SmallRoomLabs/PerspiC1/README.md

# PerspiC1 - Schematics
I wanted to see the schematics for the [PerspiC1](https://gnosia.anu.edu.au/wiki/Perspicuous_Computer_1) computer but there wasn't any PDF or image files for them on the site. So
I installed [gschem](http://wiki.geda-project.org/geda:gaf) from the [gEDA](http://www.geda-project.org/) project to be able to open the files.

Since I'm an Eagle user I won't keep the gEDA package on my laptop I made PNG screenshots of all the schematic files to have them available for future reference. They might also come in handy for anyone else that wants to see the schematics without going through the hassle of installing gEDA.

The schematics and pcbs files are copied from  
[svn.anu.edu.au/staff/bob/public/gschem-sym](http://svn.anu.edu.au/staff/bob/public/gschem-sym/)  
[svn.anu.edu.au/staff/bob/public/PerspiC1](http://svn.anu.edu.au/staff/bob/public/PerspiC1/)  

I hope that the designer of PerspiC1, Robert Edwards, don't mind me making the images publically available here.

Update April 2021 - The schematics repo seems offline, so it was a good thing that I uploaded them five years ago. I now also uploaded the wiki pages ( https://gnosia.anu.edu.au/wiki/PerspiC_1_BF_CPU ) since they might go away some day as well. 

---
### 9_bit_oc_buffer.sch
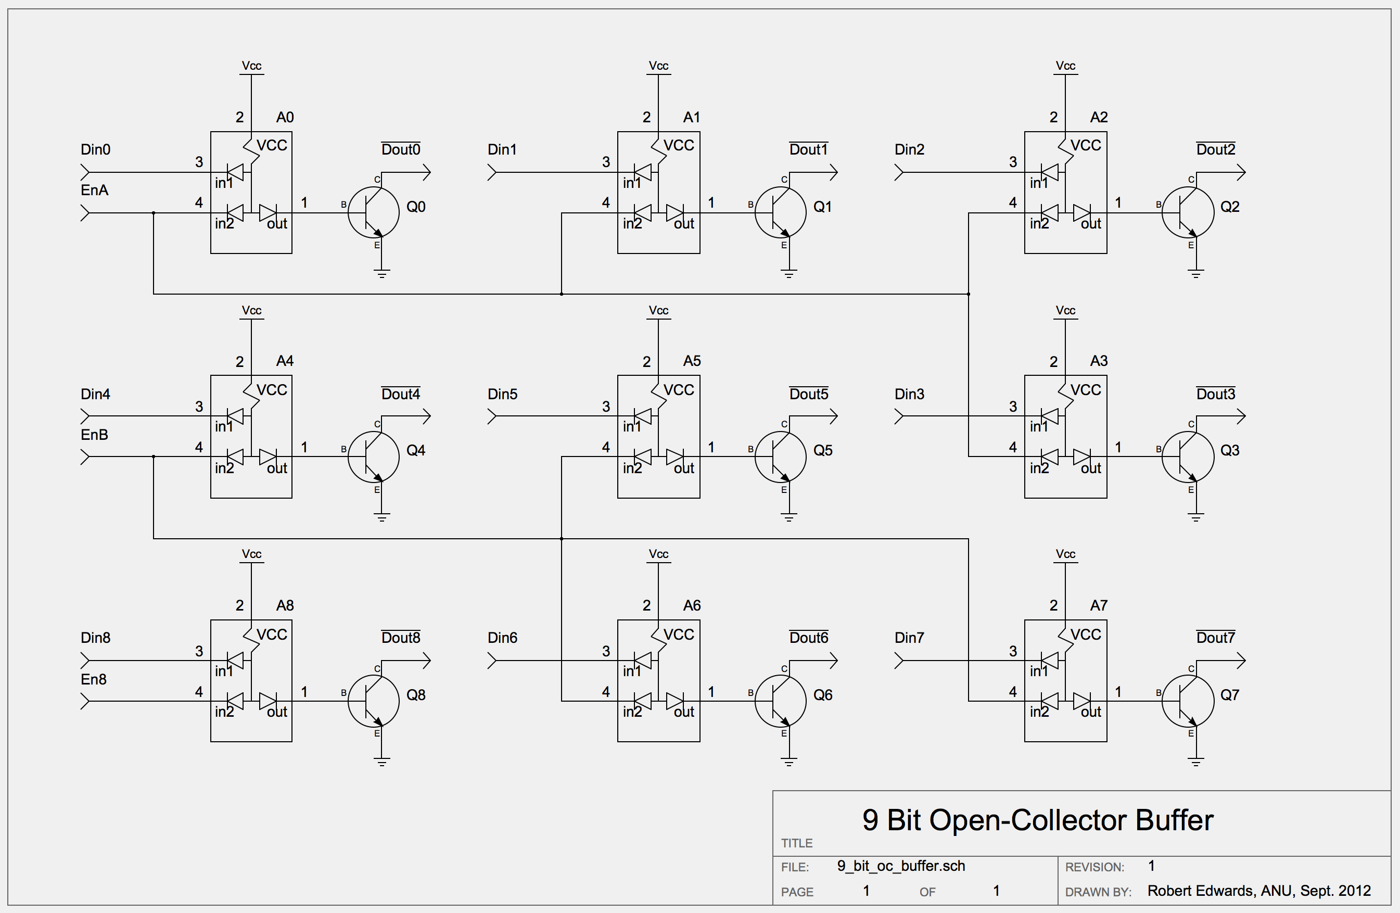
[picture p1: Images/9_bit_oc_buffer.png]


---
### DL_1_and.sch
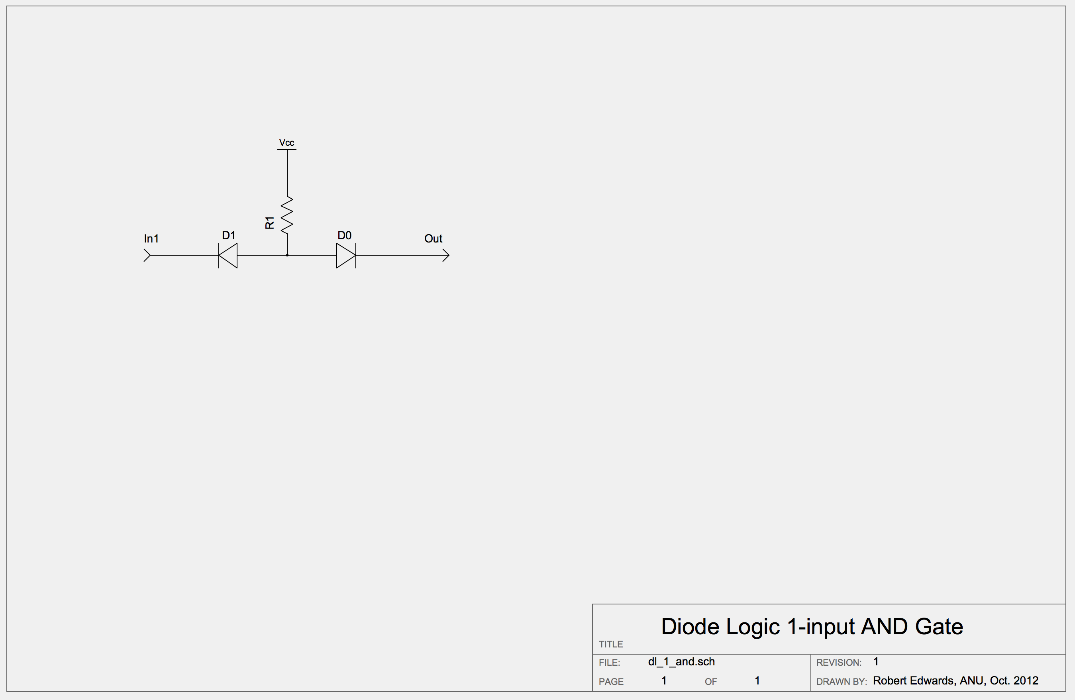
[picture p2: Images/DL_1_and.png]


---
### DL_2_and.sch
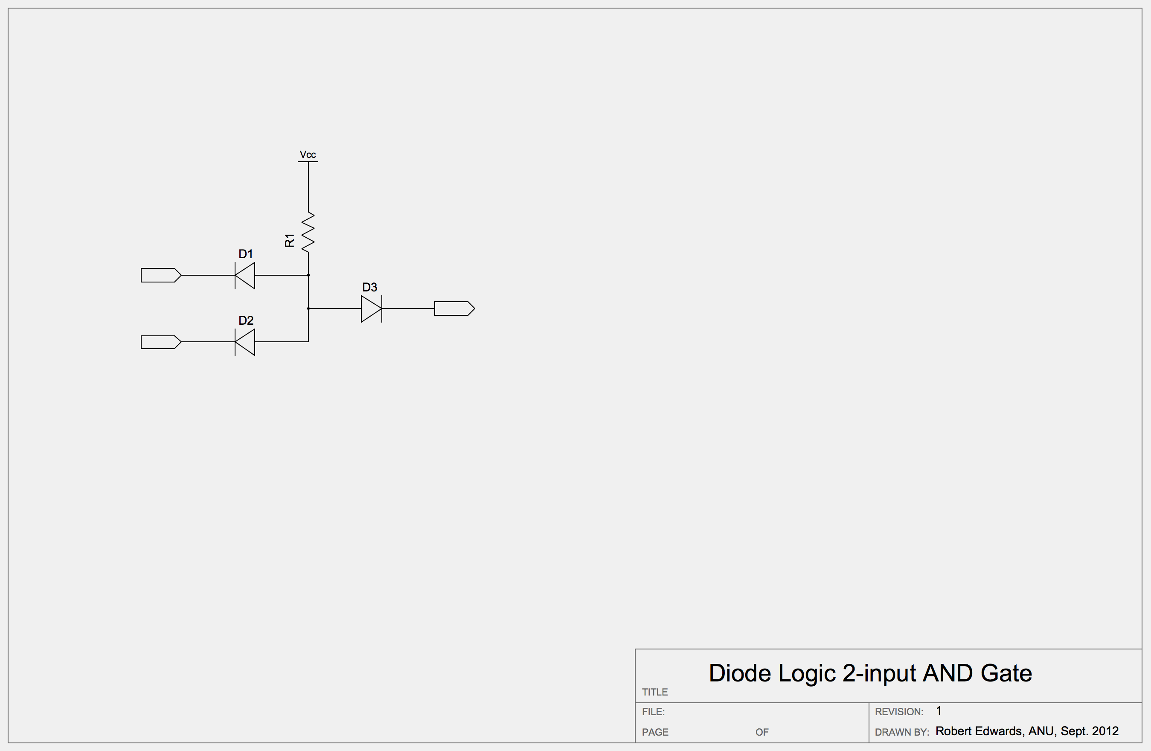
[picture p3: Images/DL_2_and.png]


---
### DL_3_and.sch
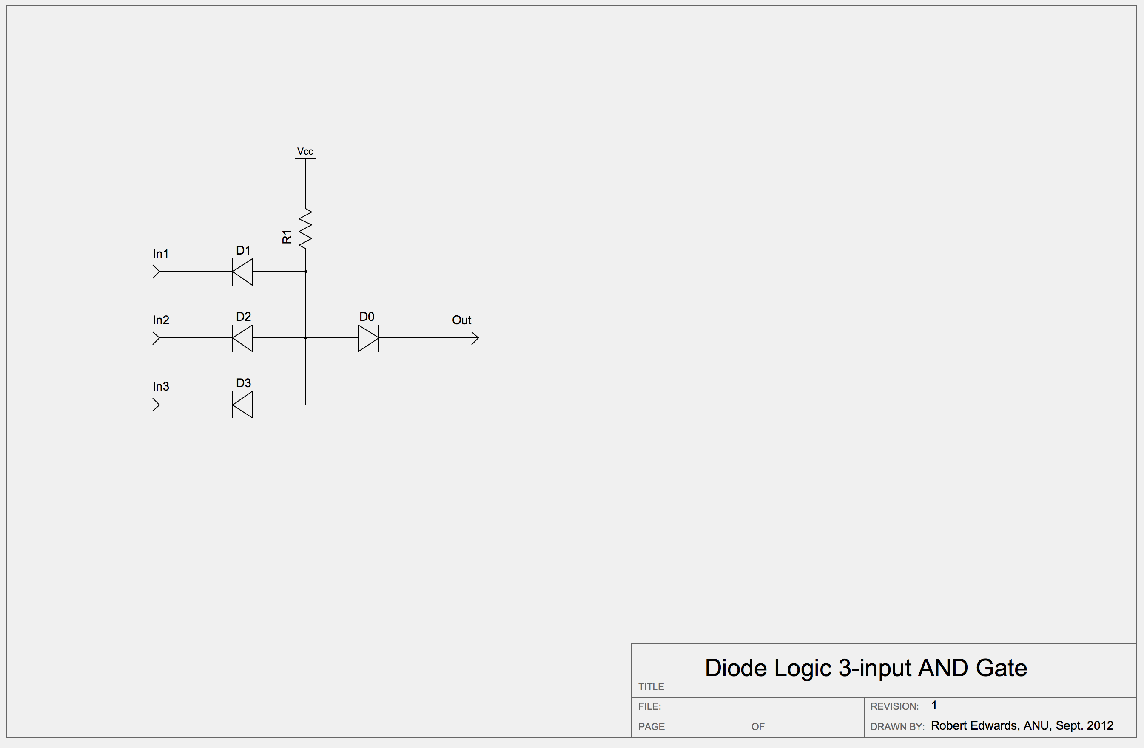
[picture p4: Images/DL_3_and.png]


---
### DL_4_and.sch
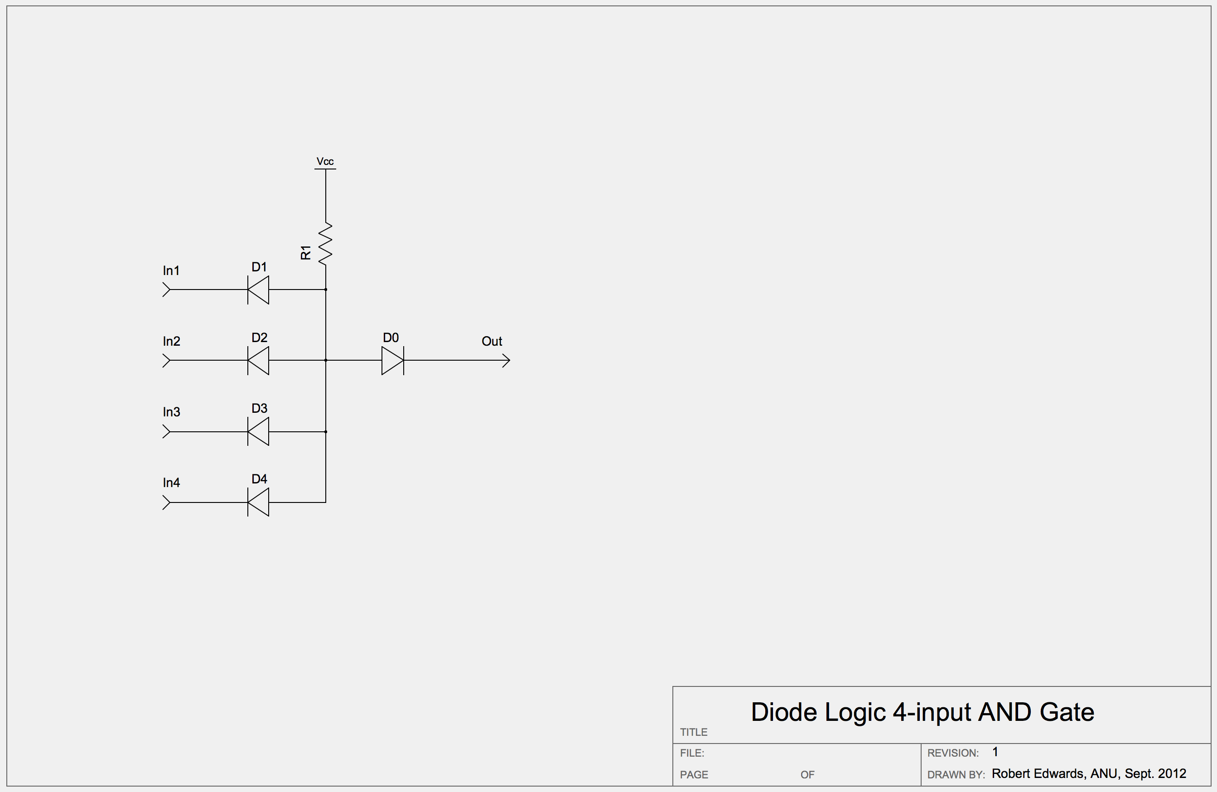
[picture p5: Images/DL_4_and.png]


---
### DTL_3_and.sch
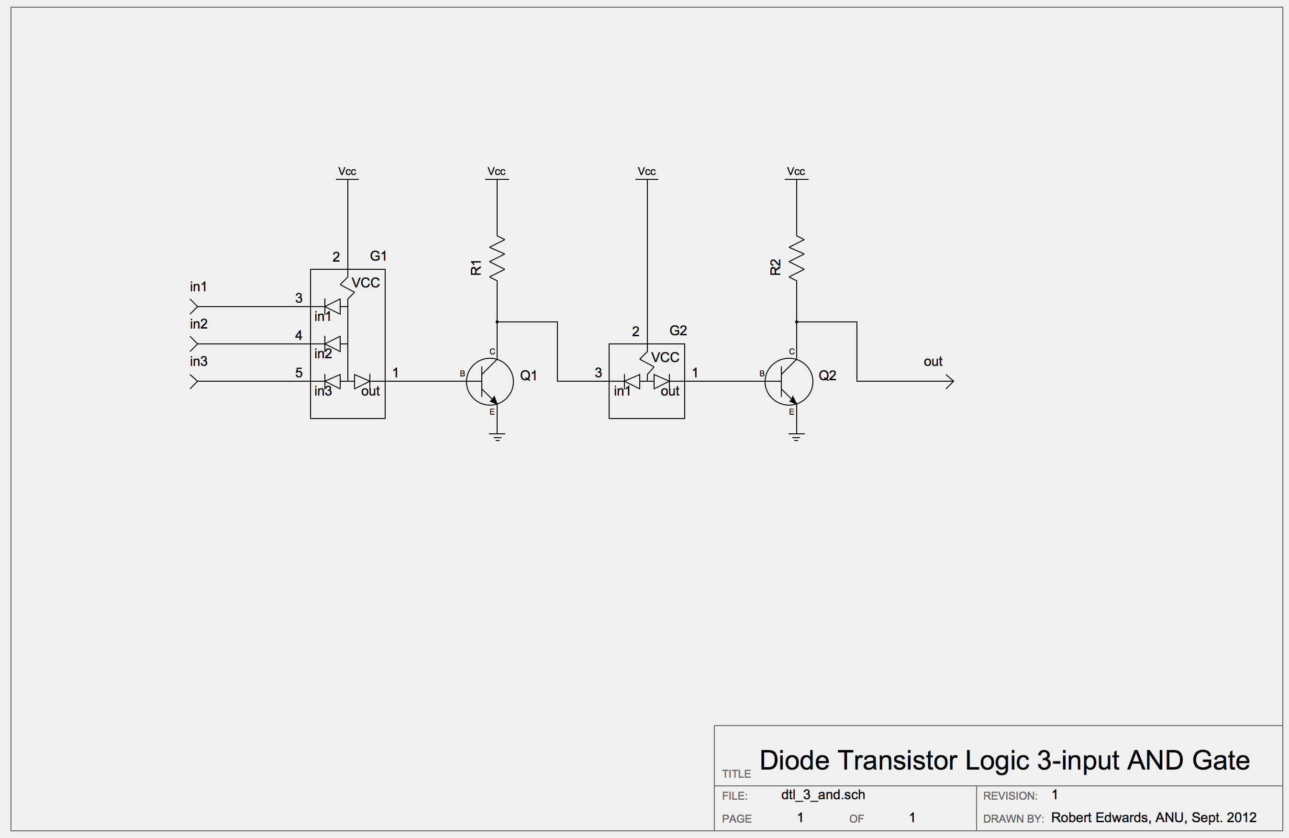
[picture p6: Images/DTL_3_and.png]


---
### DTL_4_and.sch
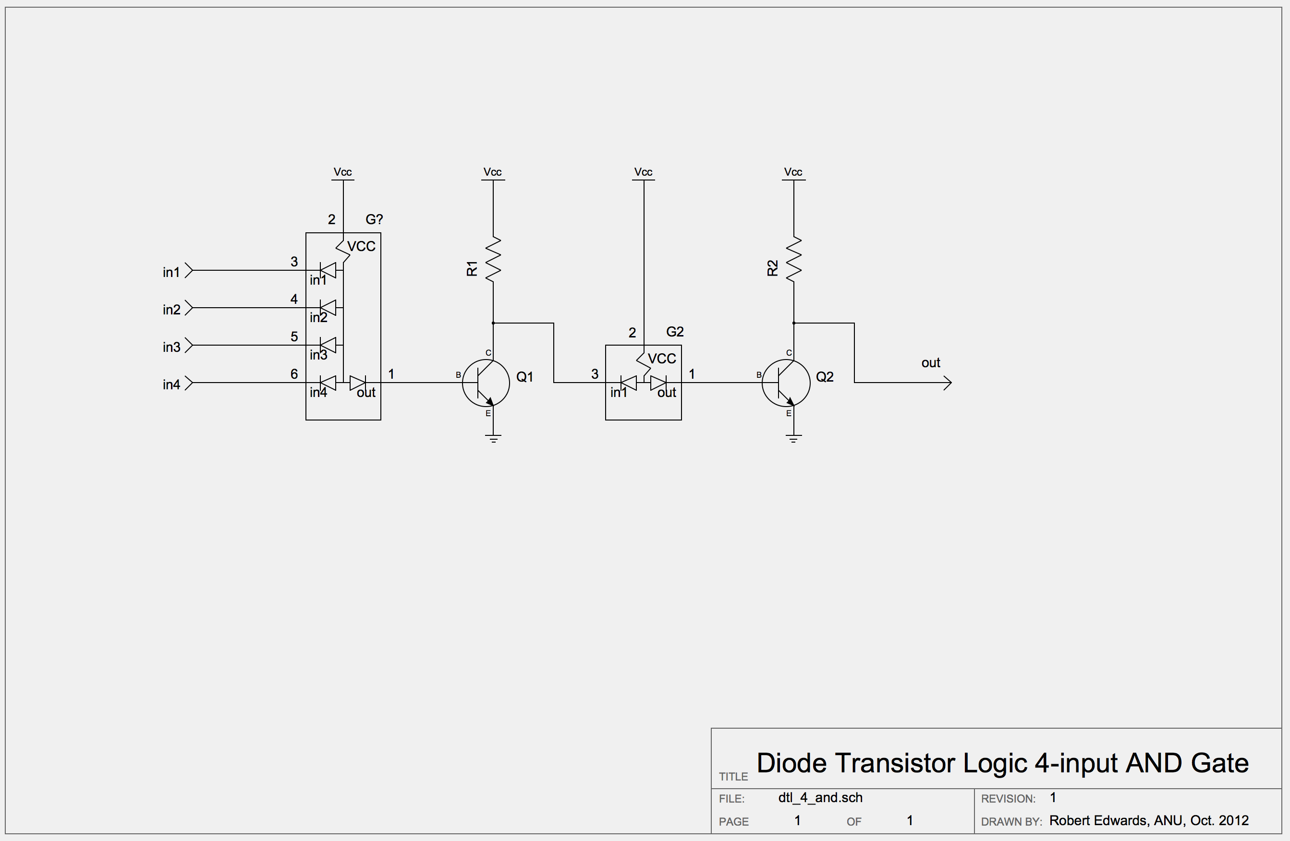
[picture p7: Images/DTL_4_and.png]


---
### DTL_4_and_nand.sch
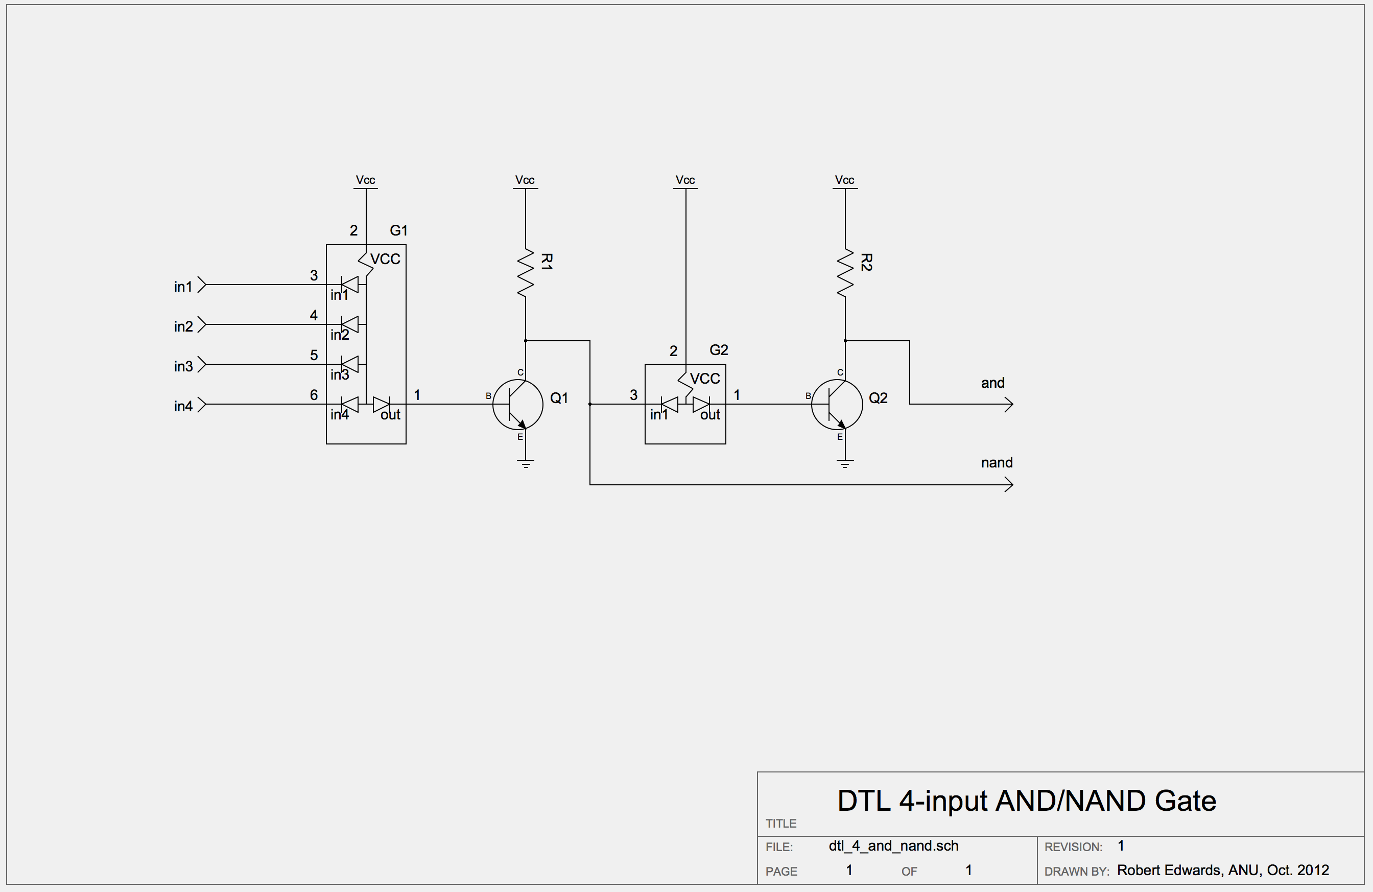
[picture p8: Images/DTL_4_and_nand.png]


---
### DTL_d_latch.sch
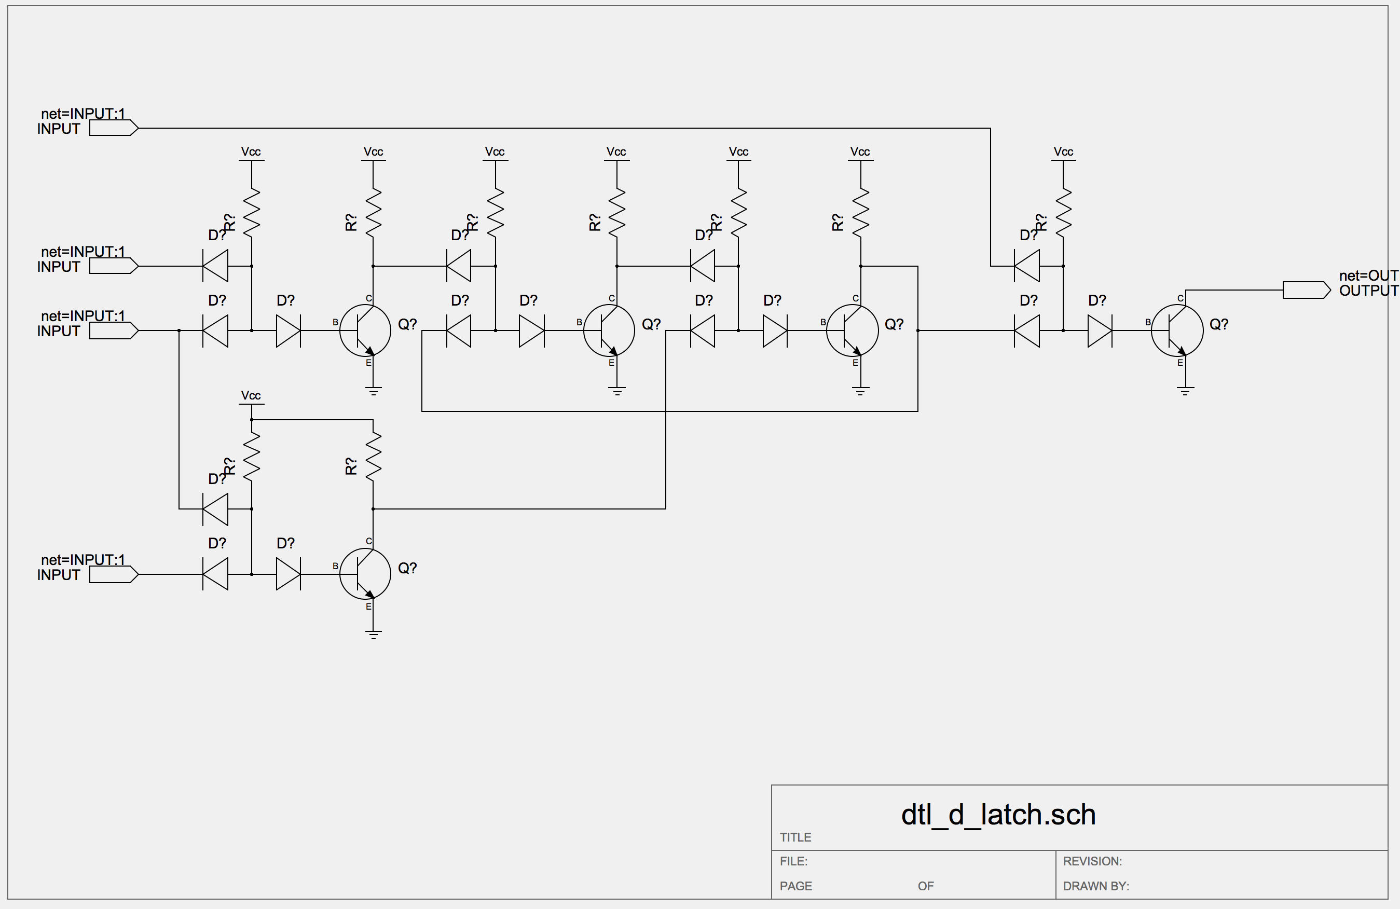
[picture p9: Images/DTL_d_latch.png]


---
### DTL_inv-1.sch
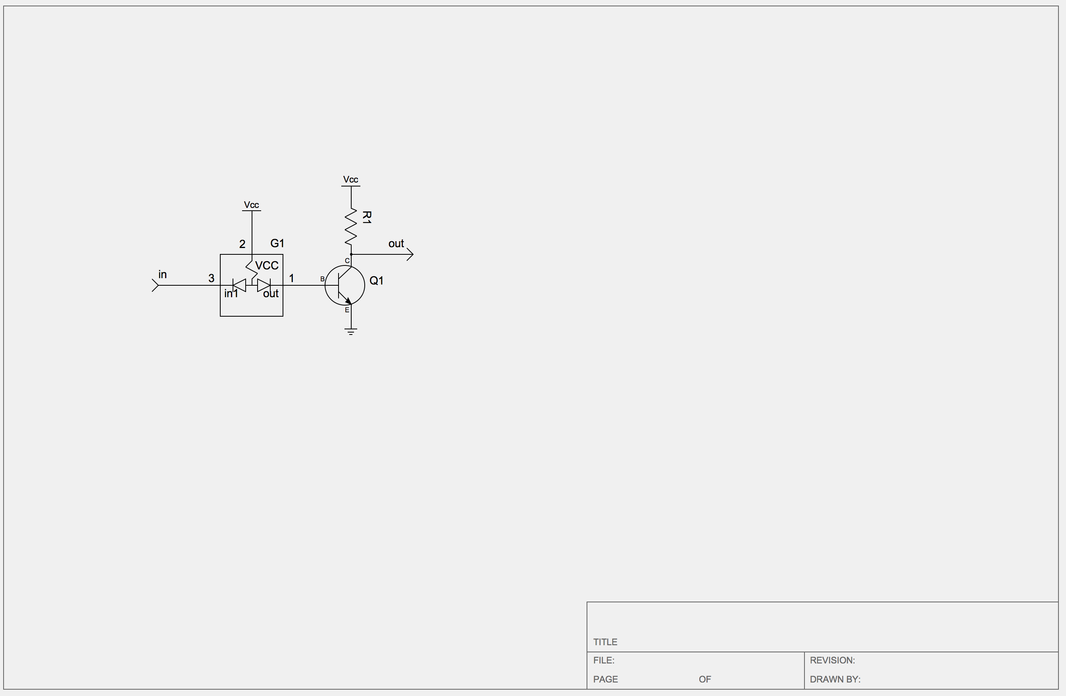
[picture p10: Images/DTL_inv-1.png]


---
### DTL_inv.sch
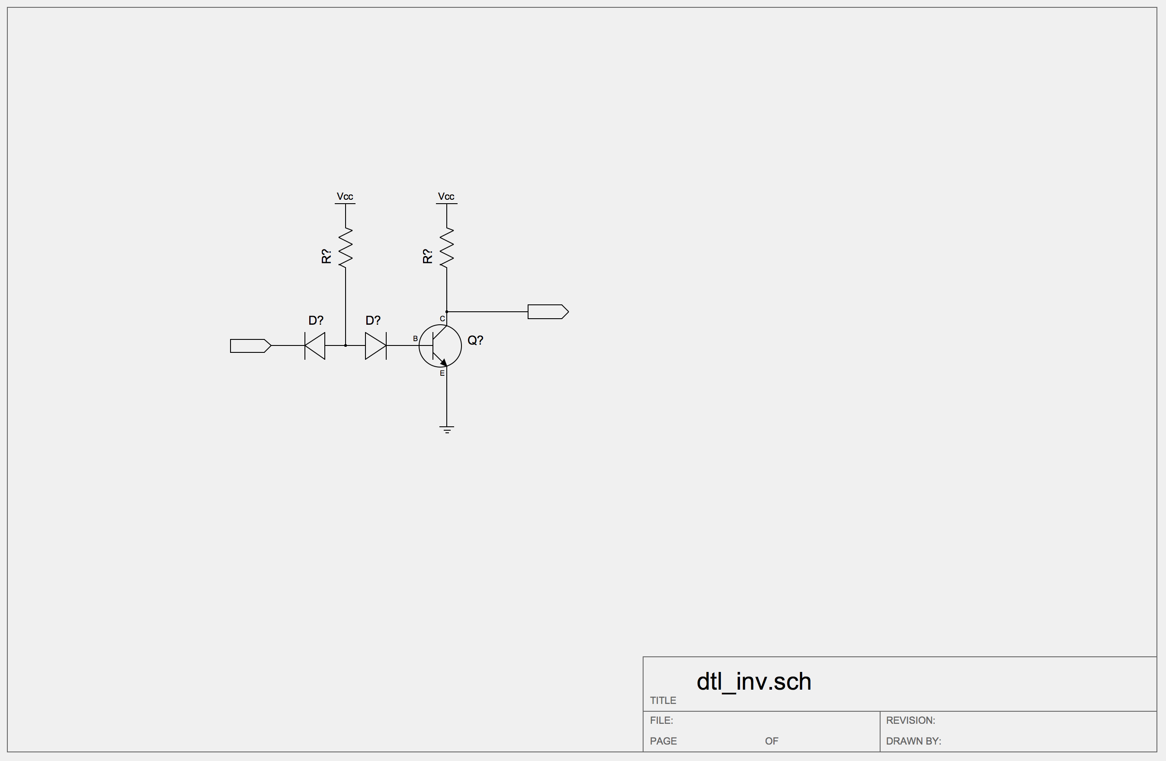
[picture p11: Images/DTL_inv.png]


---
### DTL_ph_latch.sch
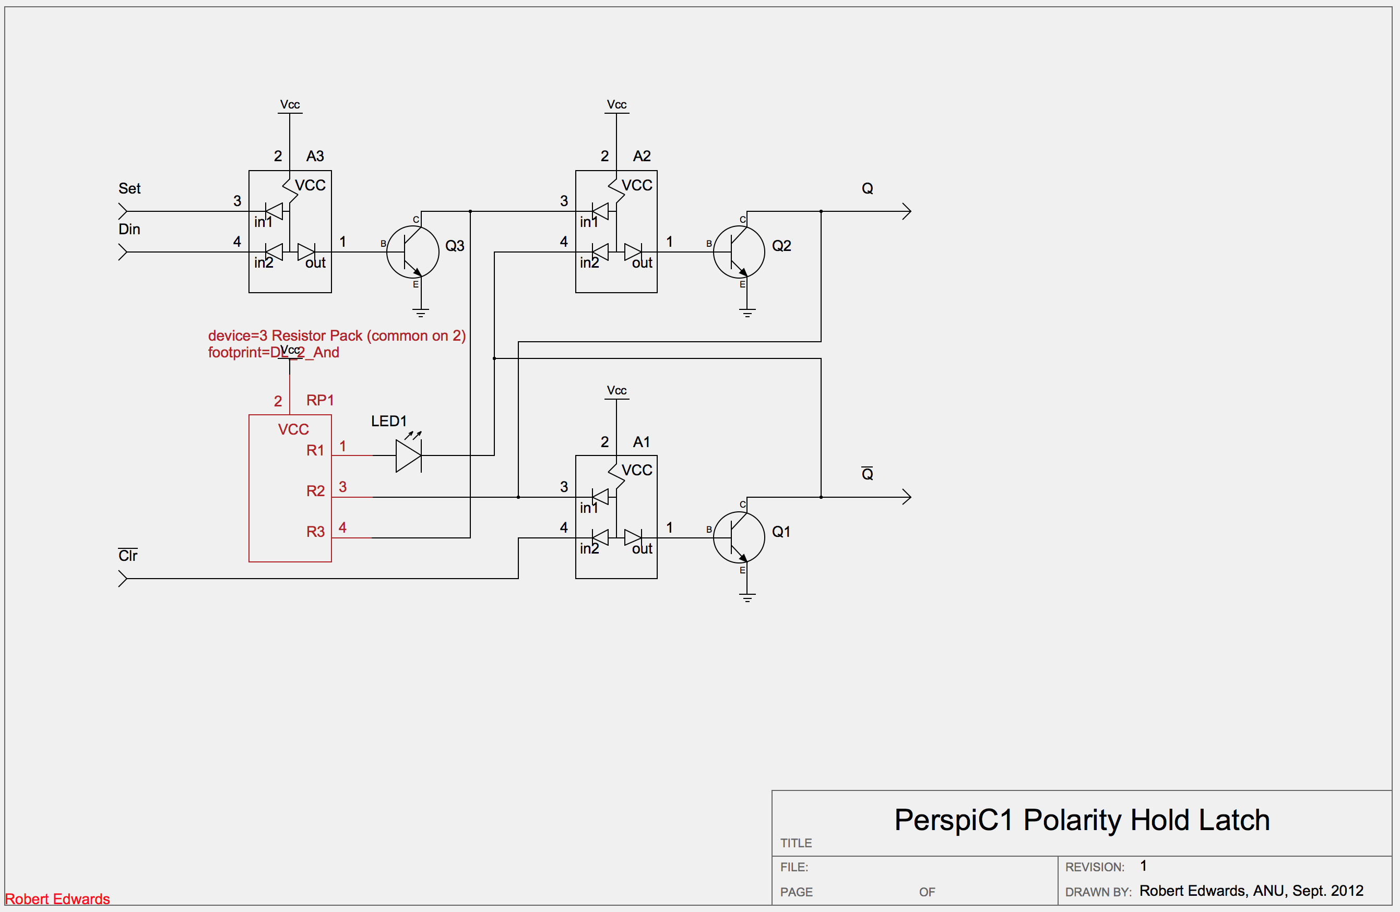
[picture p12: Images/DTL_ph_latch.png]


---
### DTL_pol_hold_latch.sch
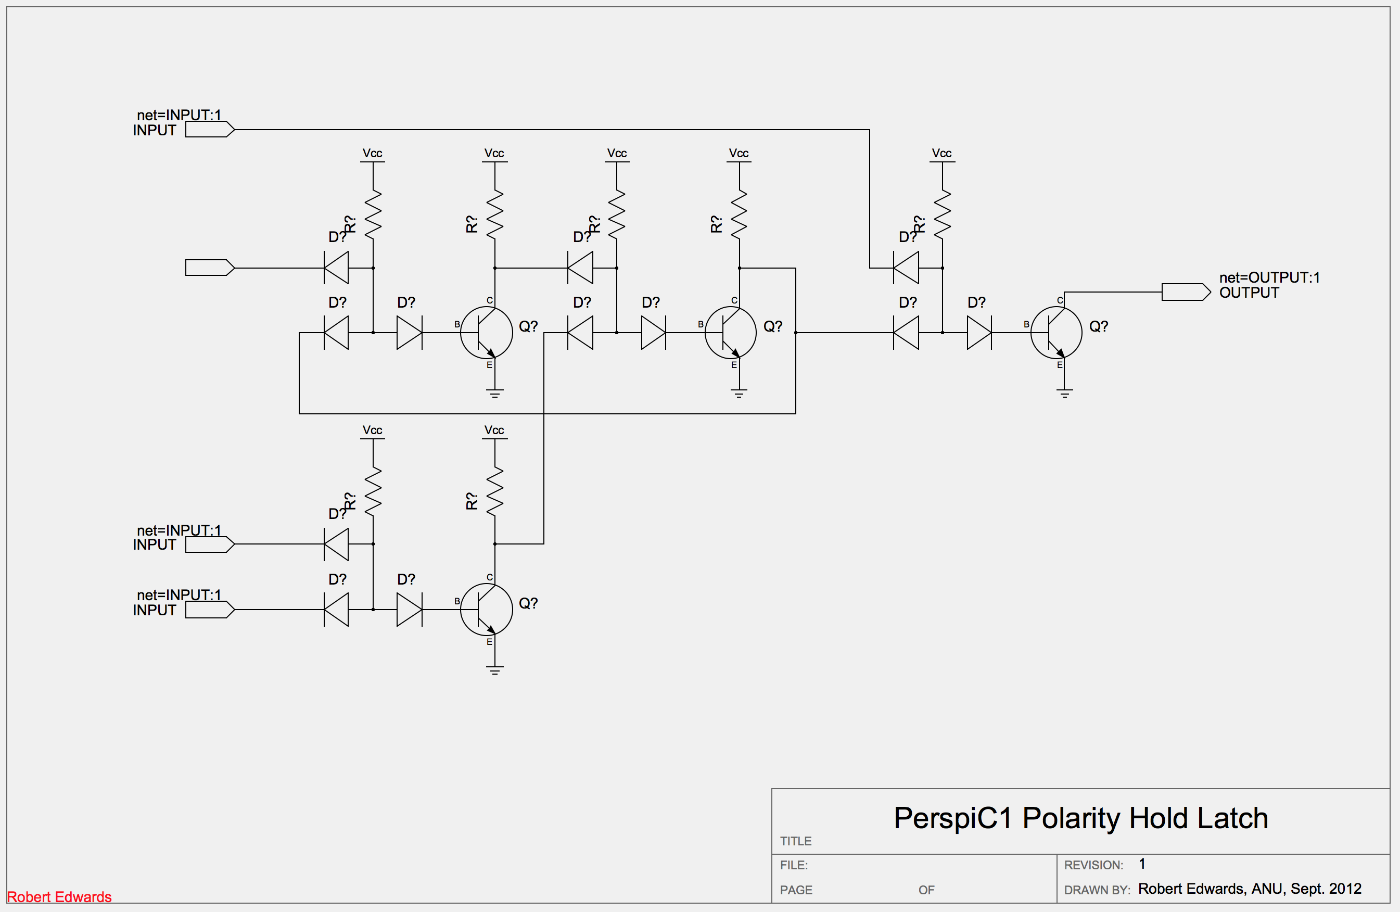
[picture p13: Images/DTL_pol_hold_latch.png]


---
### PerspiC1_RAM-1.sch
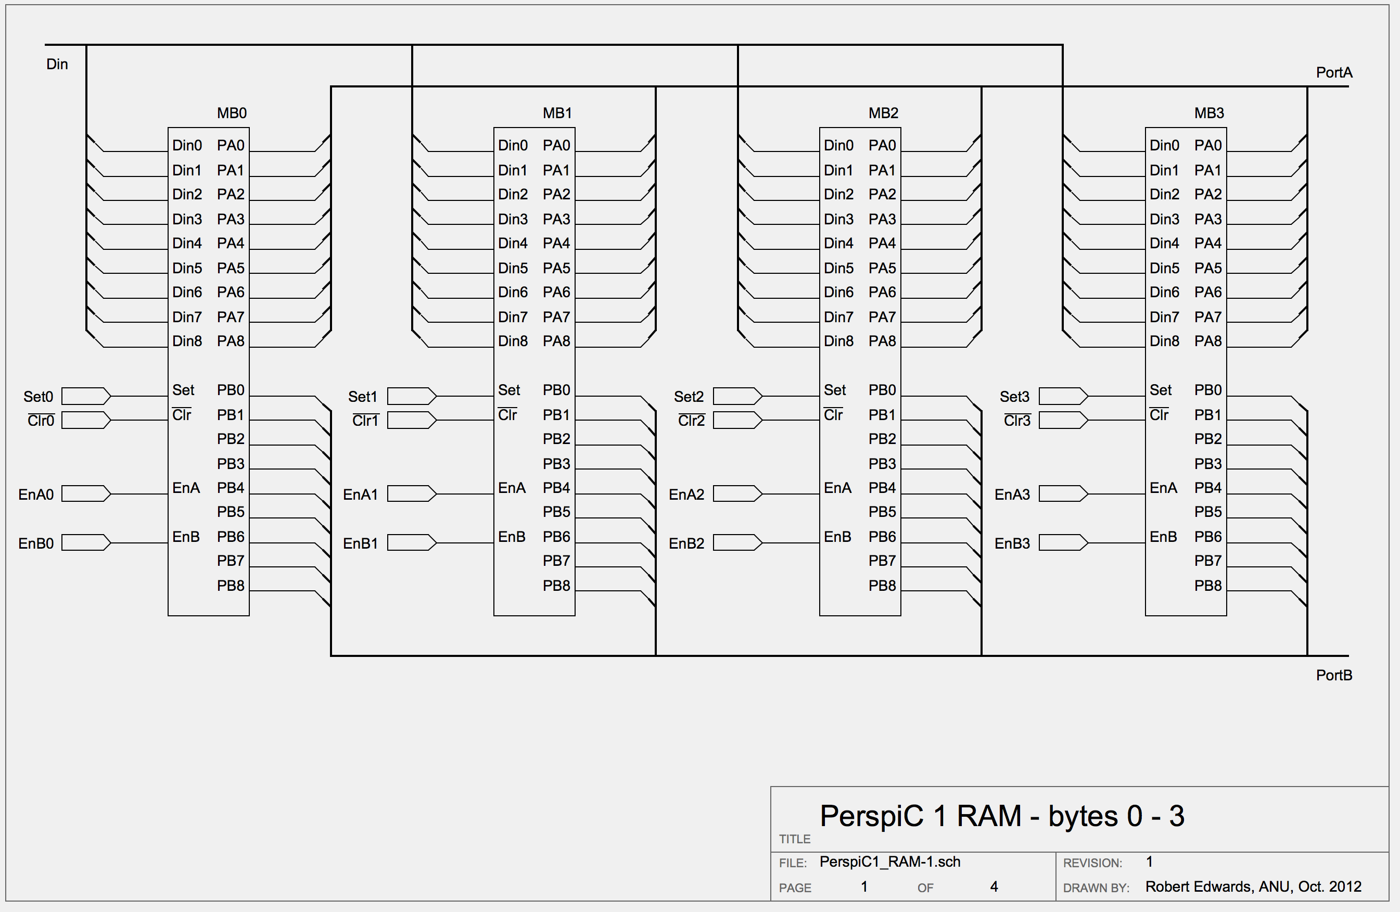
[picture p14: Images/PerspiC1_RAM-1.png]


---
### PerspiC1_RAM-2.sch
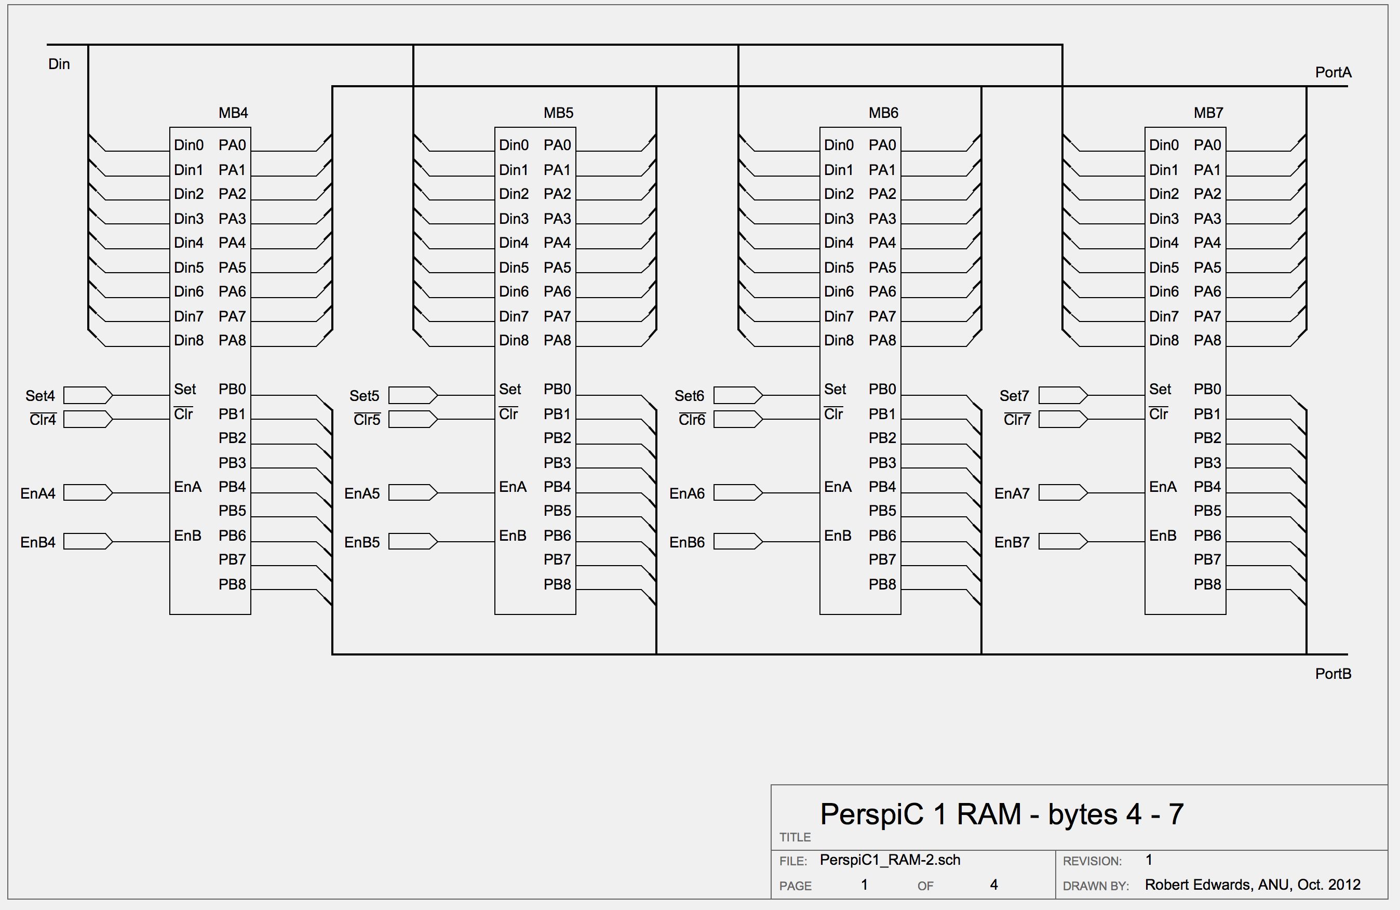
[picture p15: Images/PerspiC1_RAM-2.png]


---
### PerspiC1_RAM-3.sch
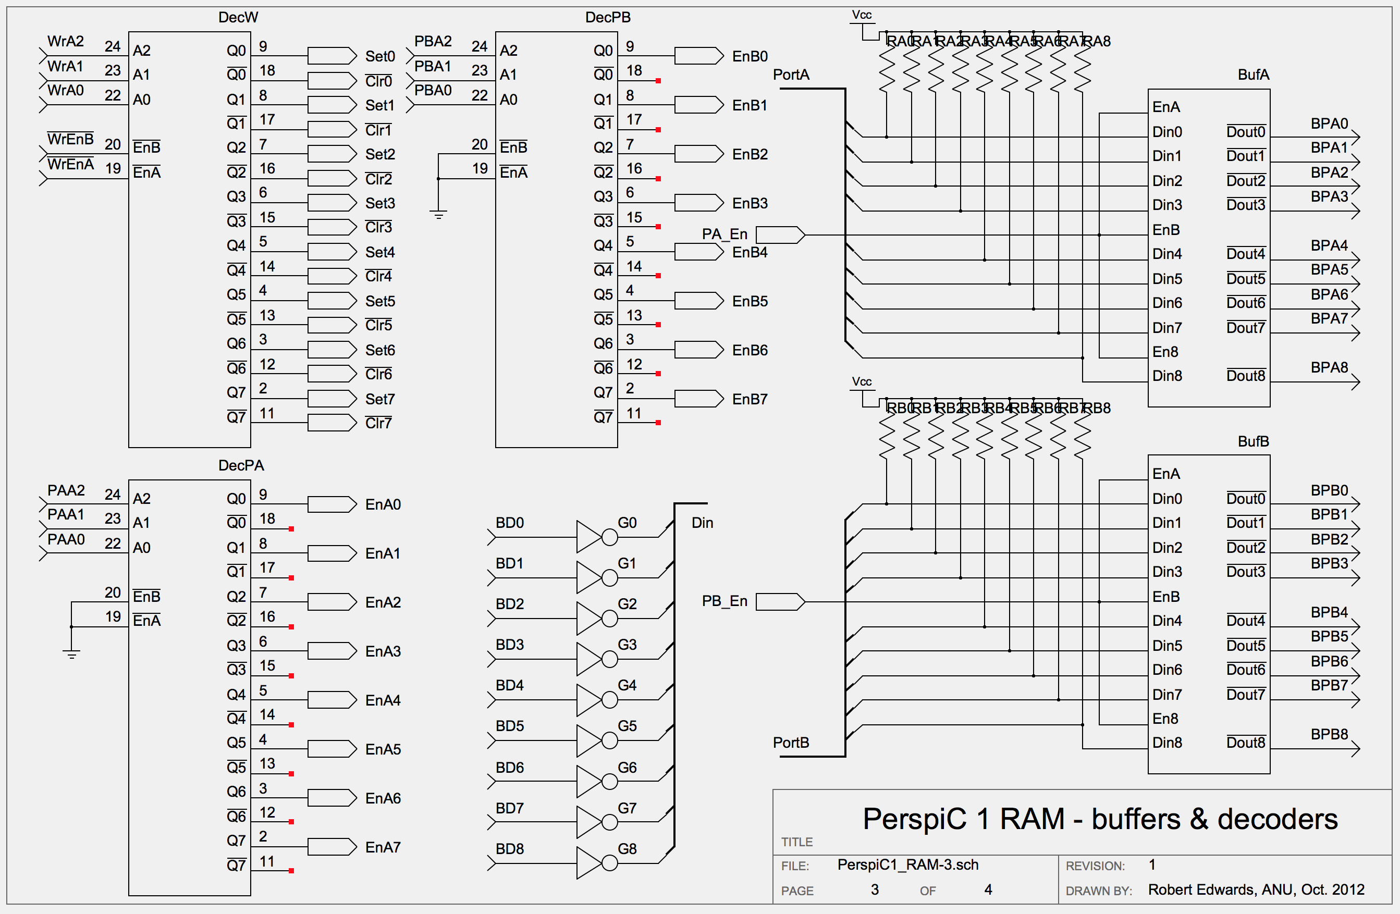
[picture p16: Images/PerspiC1_RAM-3.png]


---
### PerspiC1_RAM-Byte.sch
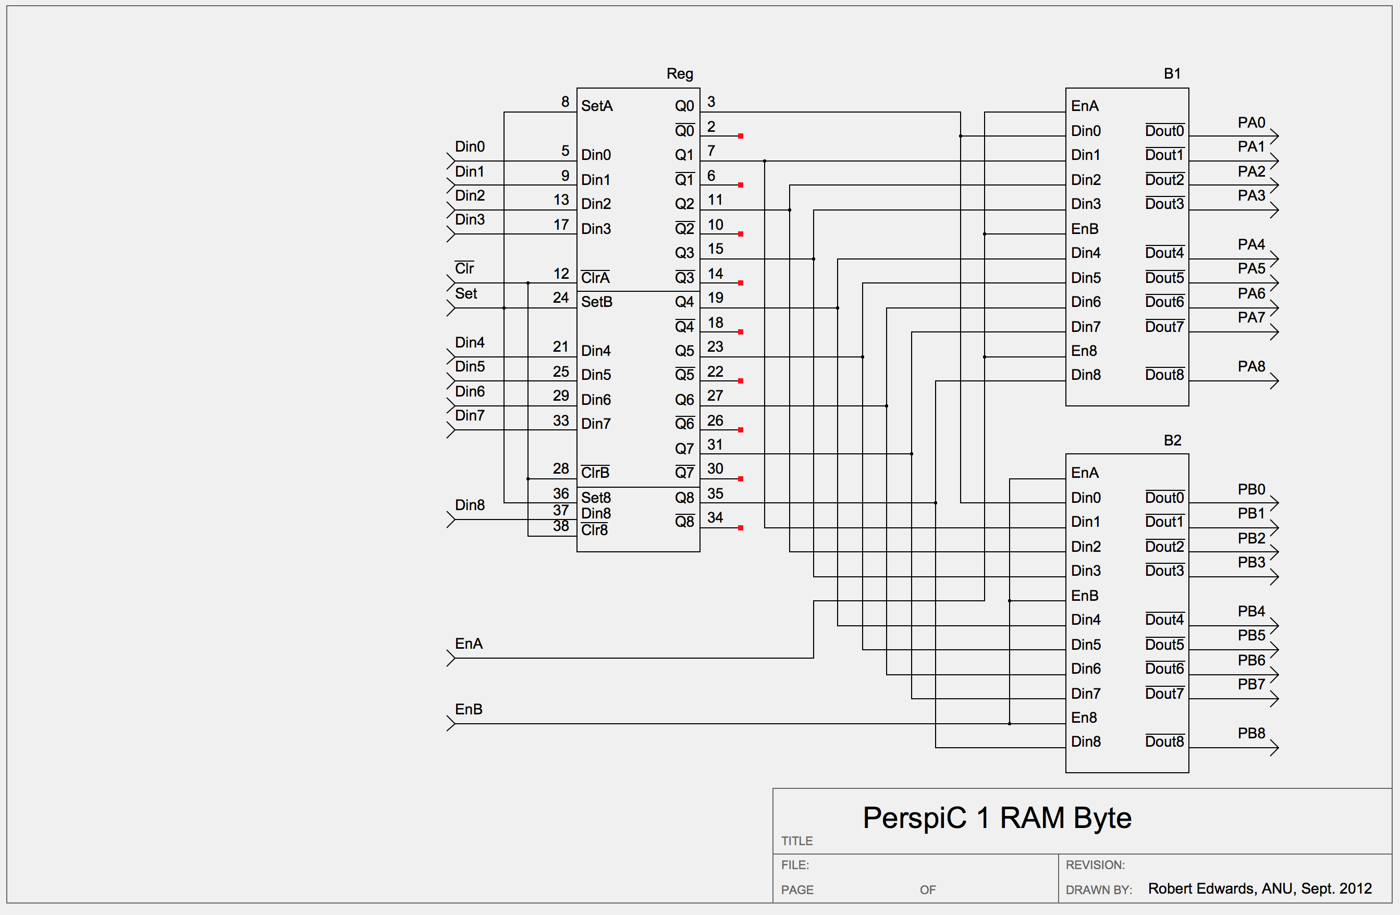
[picture p17: Images/PerspiC1_RAM-Byte.png]


---
### PerspiC1_ROM_Out.sch
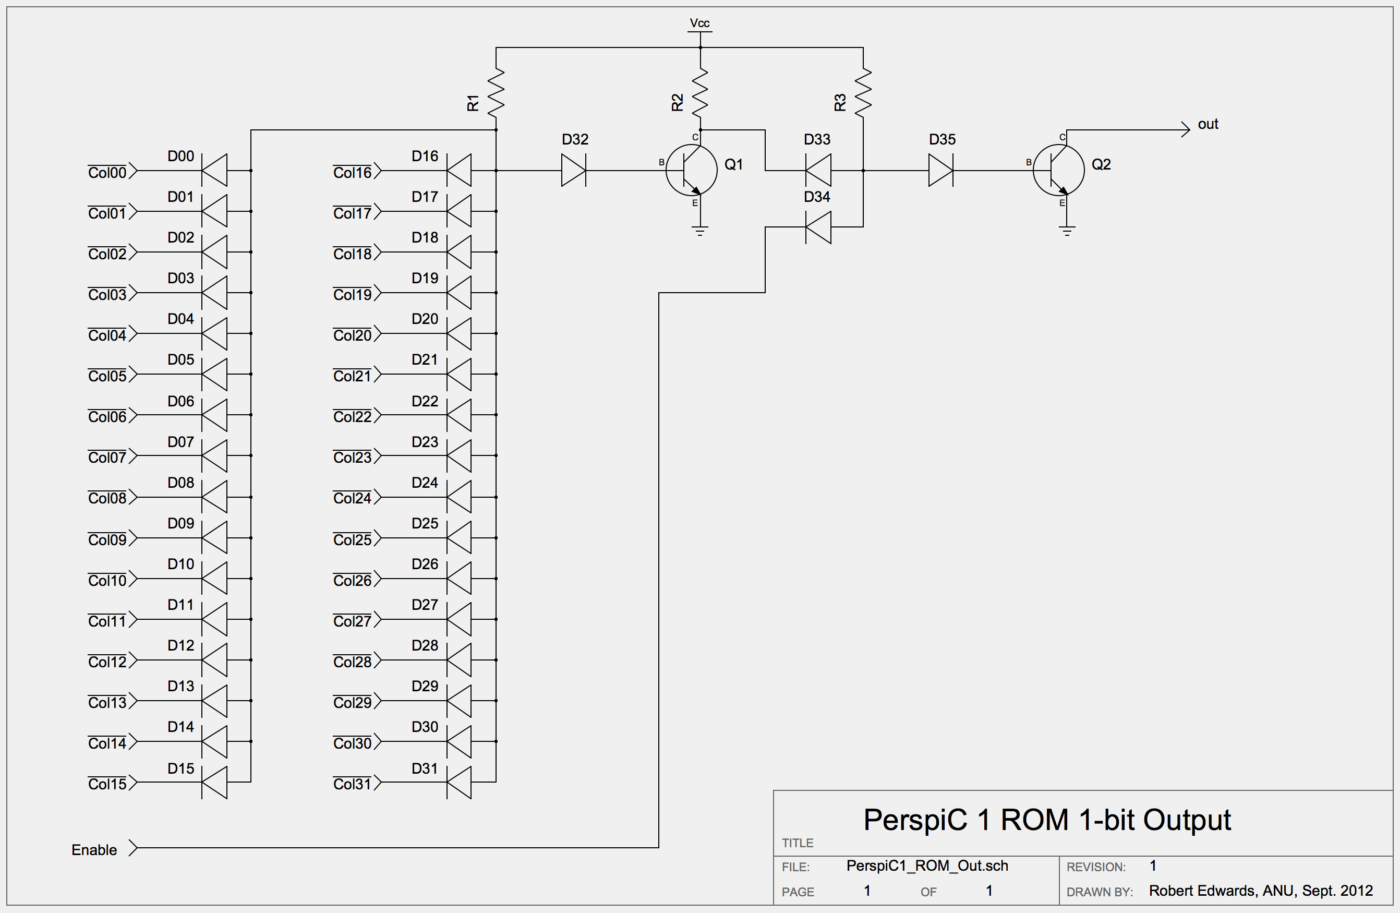
[picture p18: Images/PerspiC1_ROM_Out.png]


---
### PerspiC1_Reg.sch
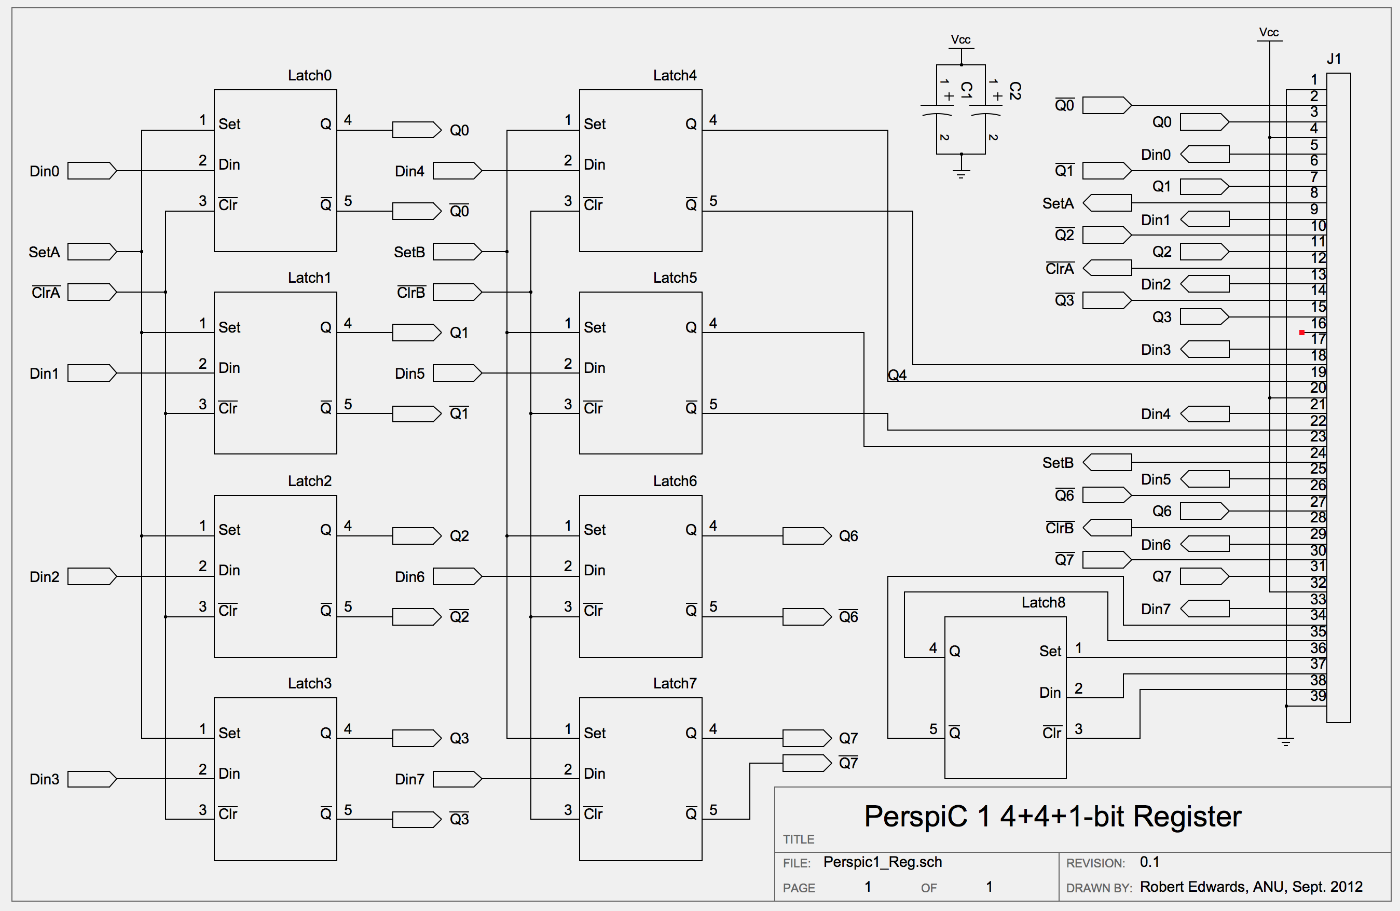
[picture p19: Images/PerspiC1_Reg.png]


---
### PerspiC1_decoder.sch
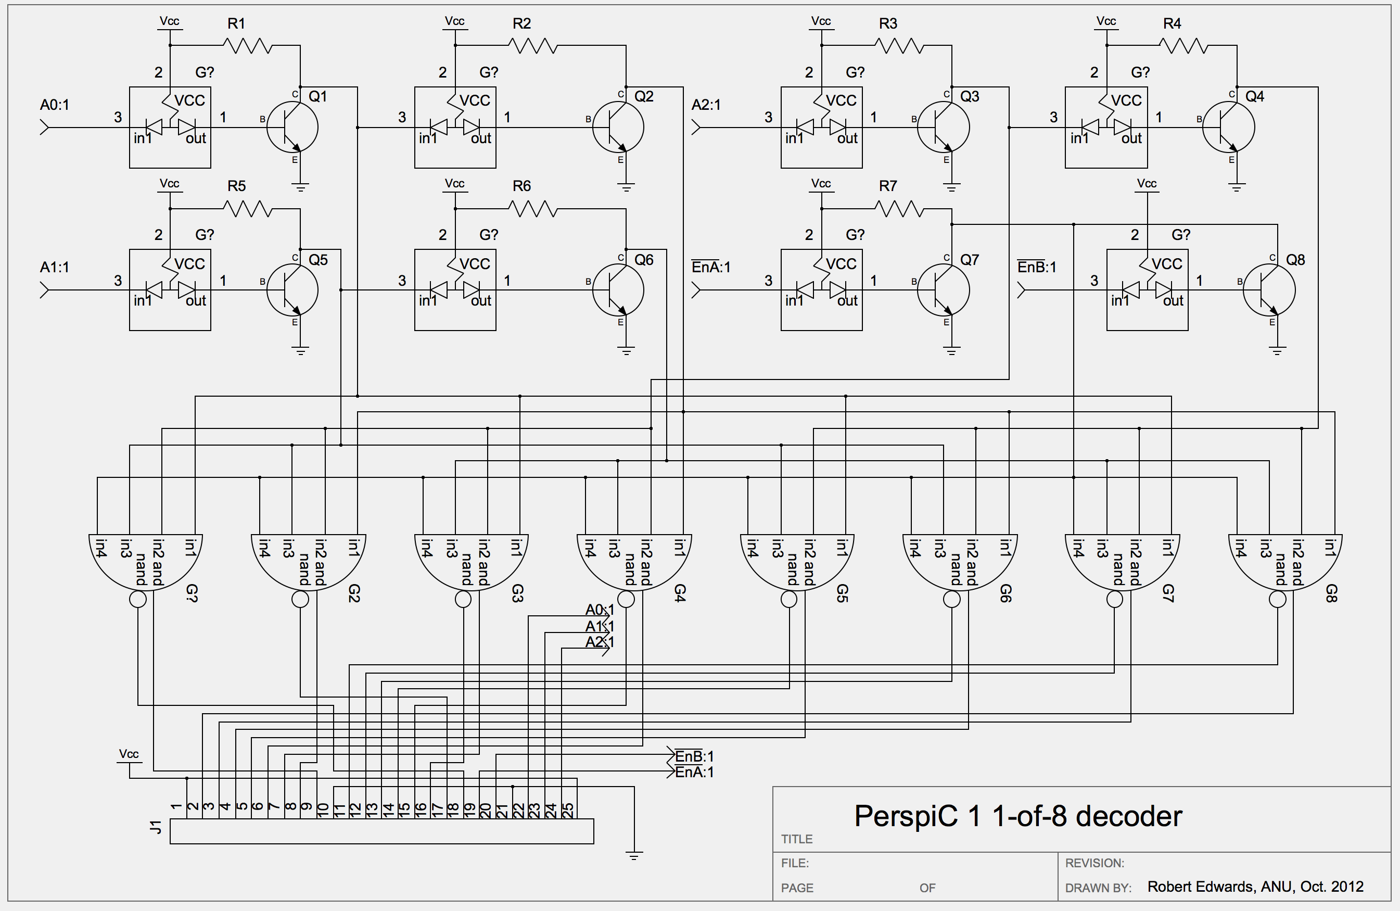
[picture p20: Images/PerspiC1_decoder.png]


---
### RTL_d_latch.sch
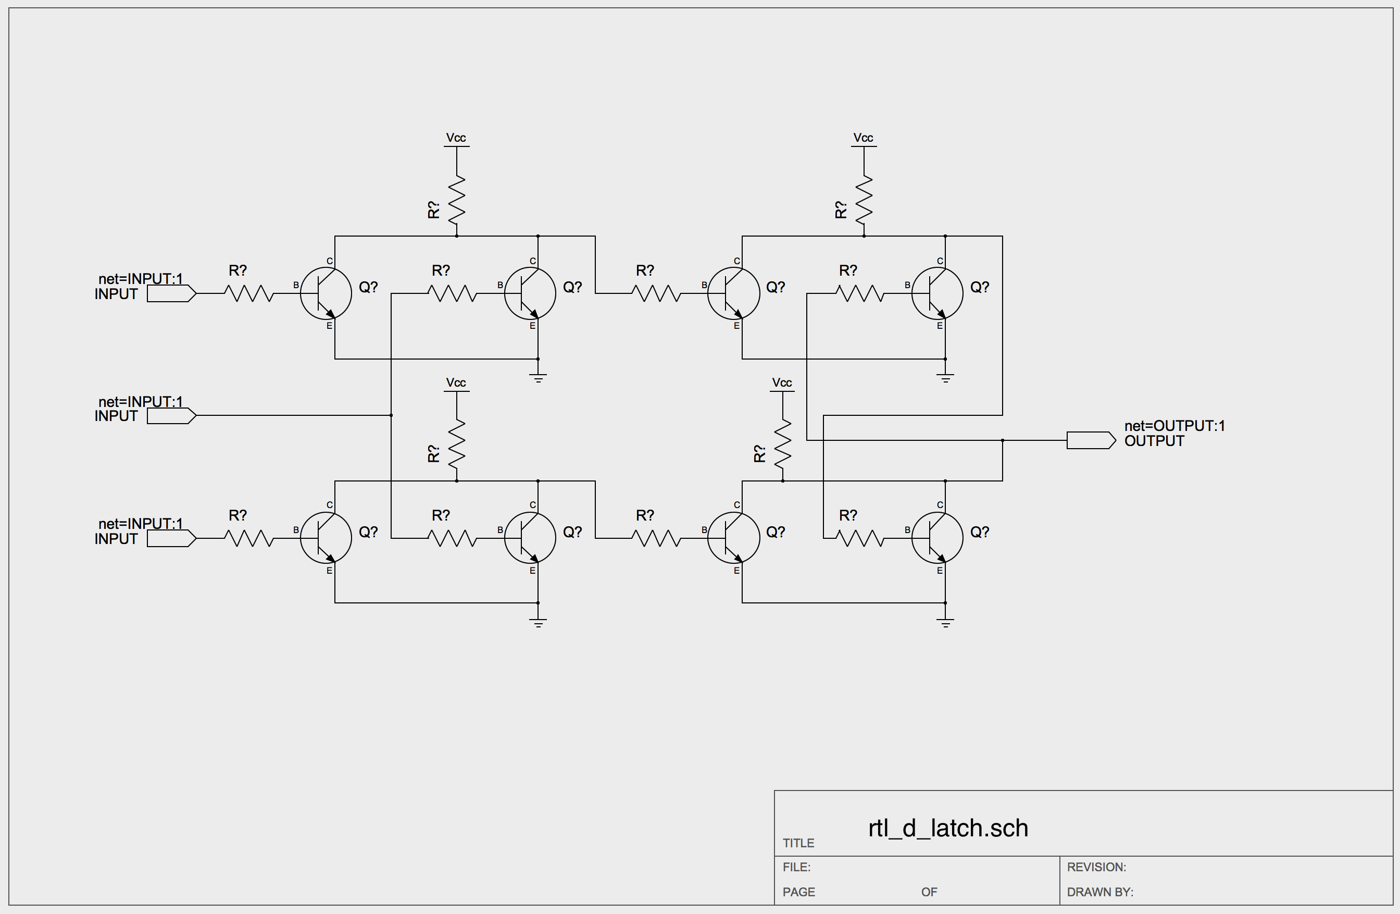
[picture p21: Images/RTL_d_latch.png]
