SmallRoomLabs/PerspiC1/(list of files, drawings)

Other design files:
PerspiC1/2x2.pcb
PerspiC1/100mmx100mm.pcb
PerspiC1/board2.pcb
PerspiC1/d0drd.pcb
PerspiC1/d1drd.pcb
PerspiC1/d2drd.pcb
PerspiC1/d3drd.pcb
PerspiC1/DIN41612-96.pcb
PerspiC1/DL_2_And.pcb
PerspiC1/PerspiC1_decoder.pcb
PerspiC1/PerspiC1_RAM.pcb
PerspiC1/PerspiC1_Reg.pcb
PerspiC1/PerspiC1_ROM.pcb
PerspiC1/PerspiC1_ROM_Mez.pcb
PerspiC1/Res_0100.pcb
PerspiC1/resistor100.pcb
