SmallRoomLabs/PerspiC1/(commit log)

2016-02-11 Added all original files
    [100mmx100mm.pcb, 2x2.pcb, 9_bit_oc_buffer.sch, DIN41612-96.pcb, DL_2_And.pcb, DL_2_And.sch, PerspiC1_RAM-1.sch, PerspiC1_RAM-2.sch]
2016-02-11 Updated readme with all the schematic images
